bbrfkr/accelerator-keyboard/case/left/case_left-top_case_left.stl

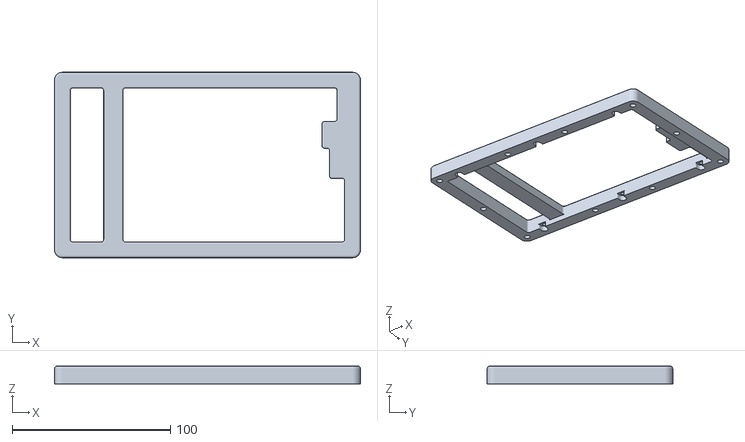
[picture p1: CAD file, 2024-07-12]
case/left/case_left-top_case_left.stl
193.5 x 117.3 x 11.2
