bbrfkr/accelerator-keyboard/case/right/case_right-bottom_right.stl

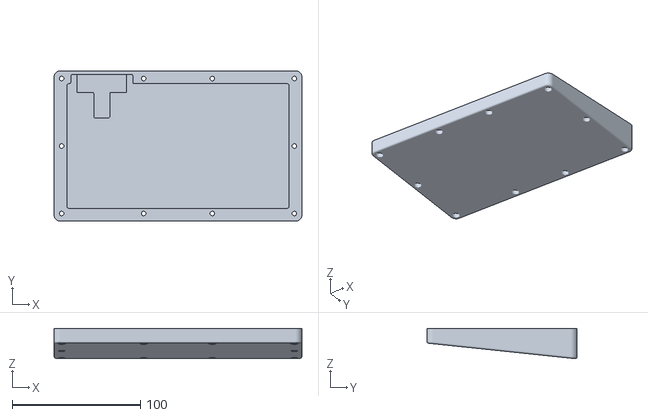
[picture p2: CAD file, 2024-07-12]
case/right/case_right-bottom_right.stl
193.5 x 117.3 x 23.7
