bbrfkr/accelerator-keyboard/pcb-left.dxf

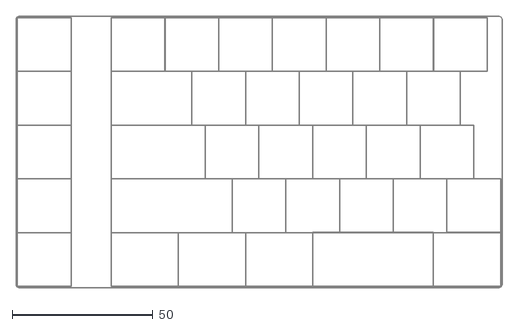
[picture p3: CAD file, 2024-07-12]
pcb-left.dxf
172.4 x 96.2
