bbrfkr/accelerator-keyboard/plate/org/plate-left.dxf

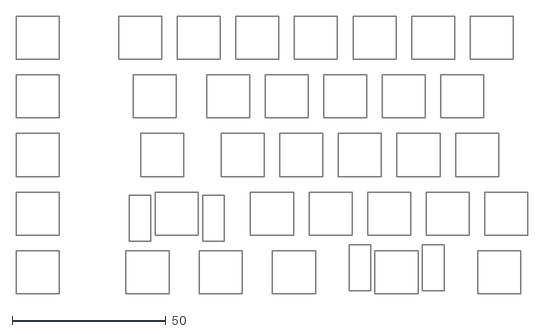
[picture p4: CAD file, 2024-05-05]
plate/org/plate-left.dxf
166.4 x 90.2
