bbrfkr/accelerator-keyboard/plate/plate.dxf

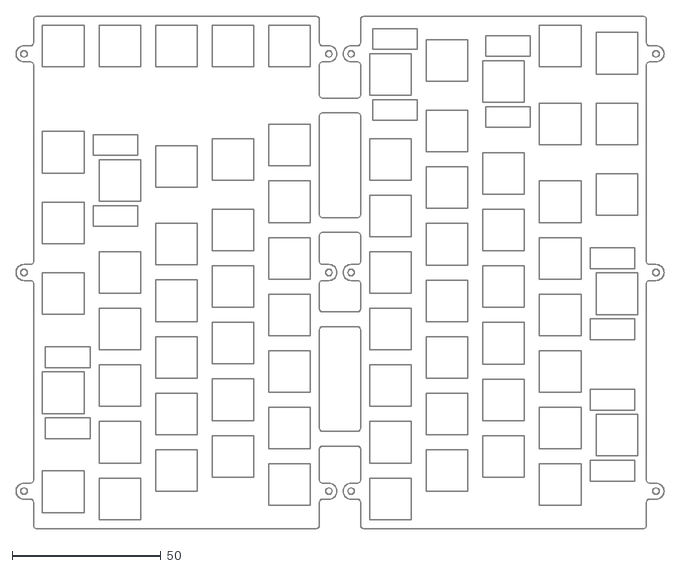
[picture p5: CAD file, 2024-07-12]
plate/plate.dxf
218.2 x 172.4
