bbrfkr/accelerator-keyboard/case/right/case_right.FCStd

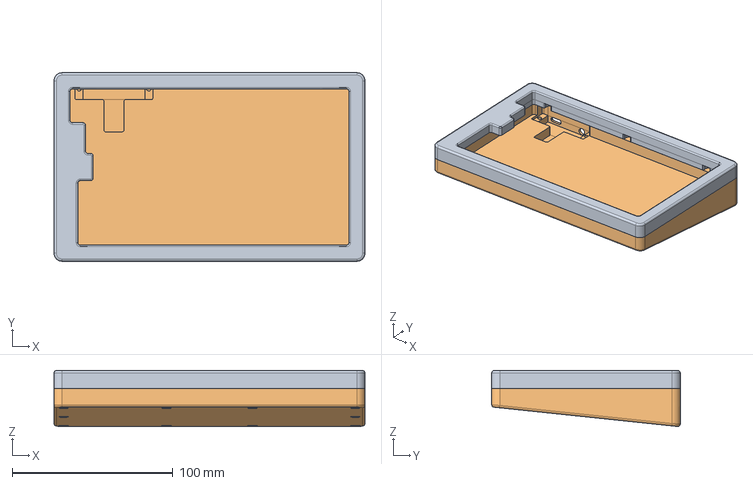
[picture p6: CAD file, 2024-07-12]
case/right/case_right.FCStd
193.5 x 117.3 x 34.9 mm
top_right
bottom_right
