bbrfkr/accelerator-keyboard/pcb-right.dxf

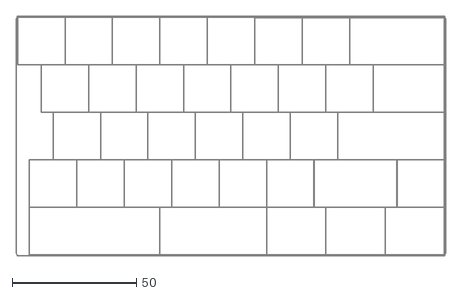
[picture p7: CAD file, 2024-07-12]
pcb-right.dxf
172.4 x 96.2
