bbrfkr/accelerator-keyboard/plate/org/plate-right.dxf

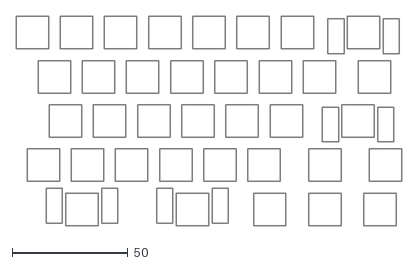
[picture p8: CAD file, 2024-05-05]
plate/org/plate-right.dxf
166.4 x 90.2
