bbrfkr/accelerator-keyboard/case/right/case_right-top_right.stl

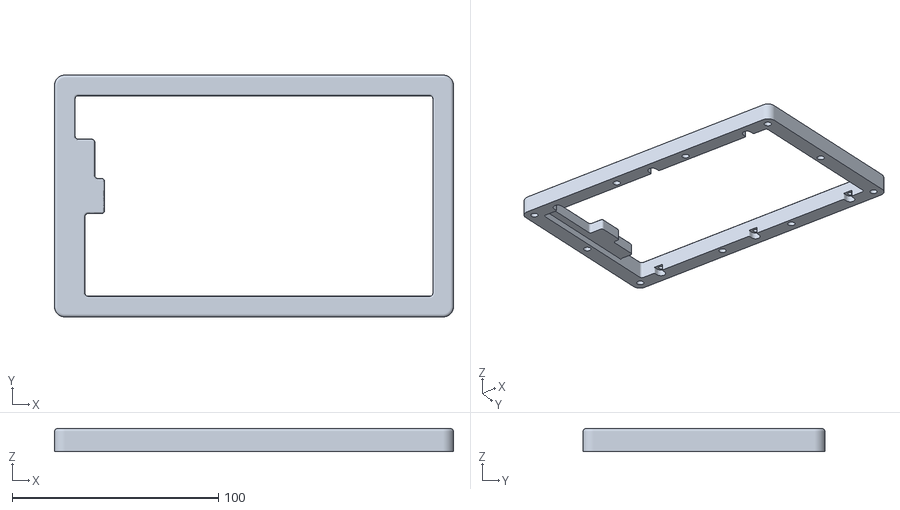
[picture p9: CAD file, 2024-07-12]
case/right/case_right-top_right.stl
193.5 x 117.3 x 11.2
