bbrfkr/accelerator-keyboard/(list of files, cad)

Other CAD files:
case/left/case_left-bottom_left.stl
