bbrfkr/accelerator-keyboard/accelerator.kicad_pcb

## KiCad design accelerator.kicad_pcb (2024-05-05)

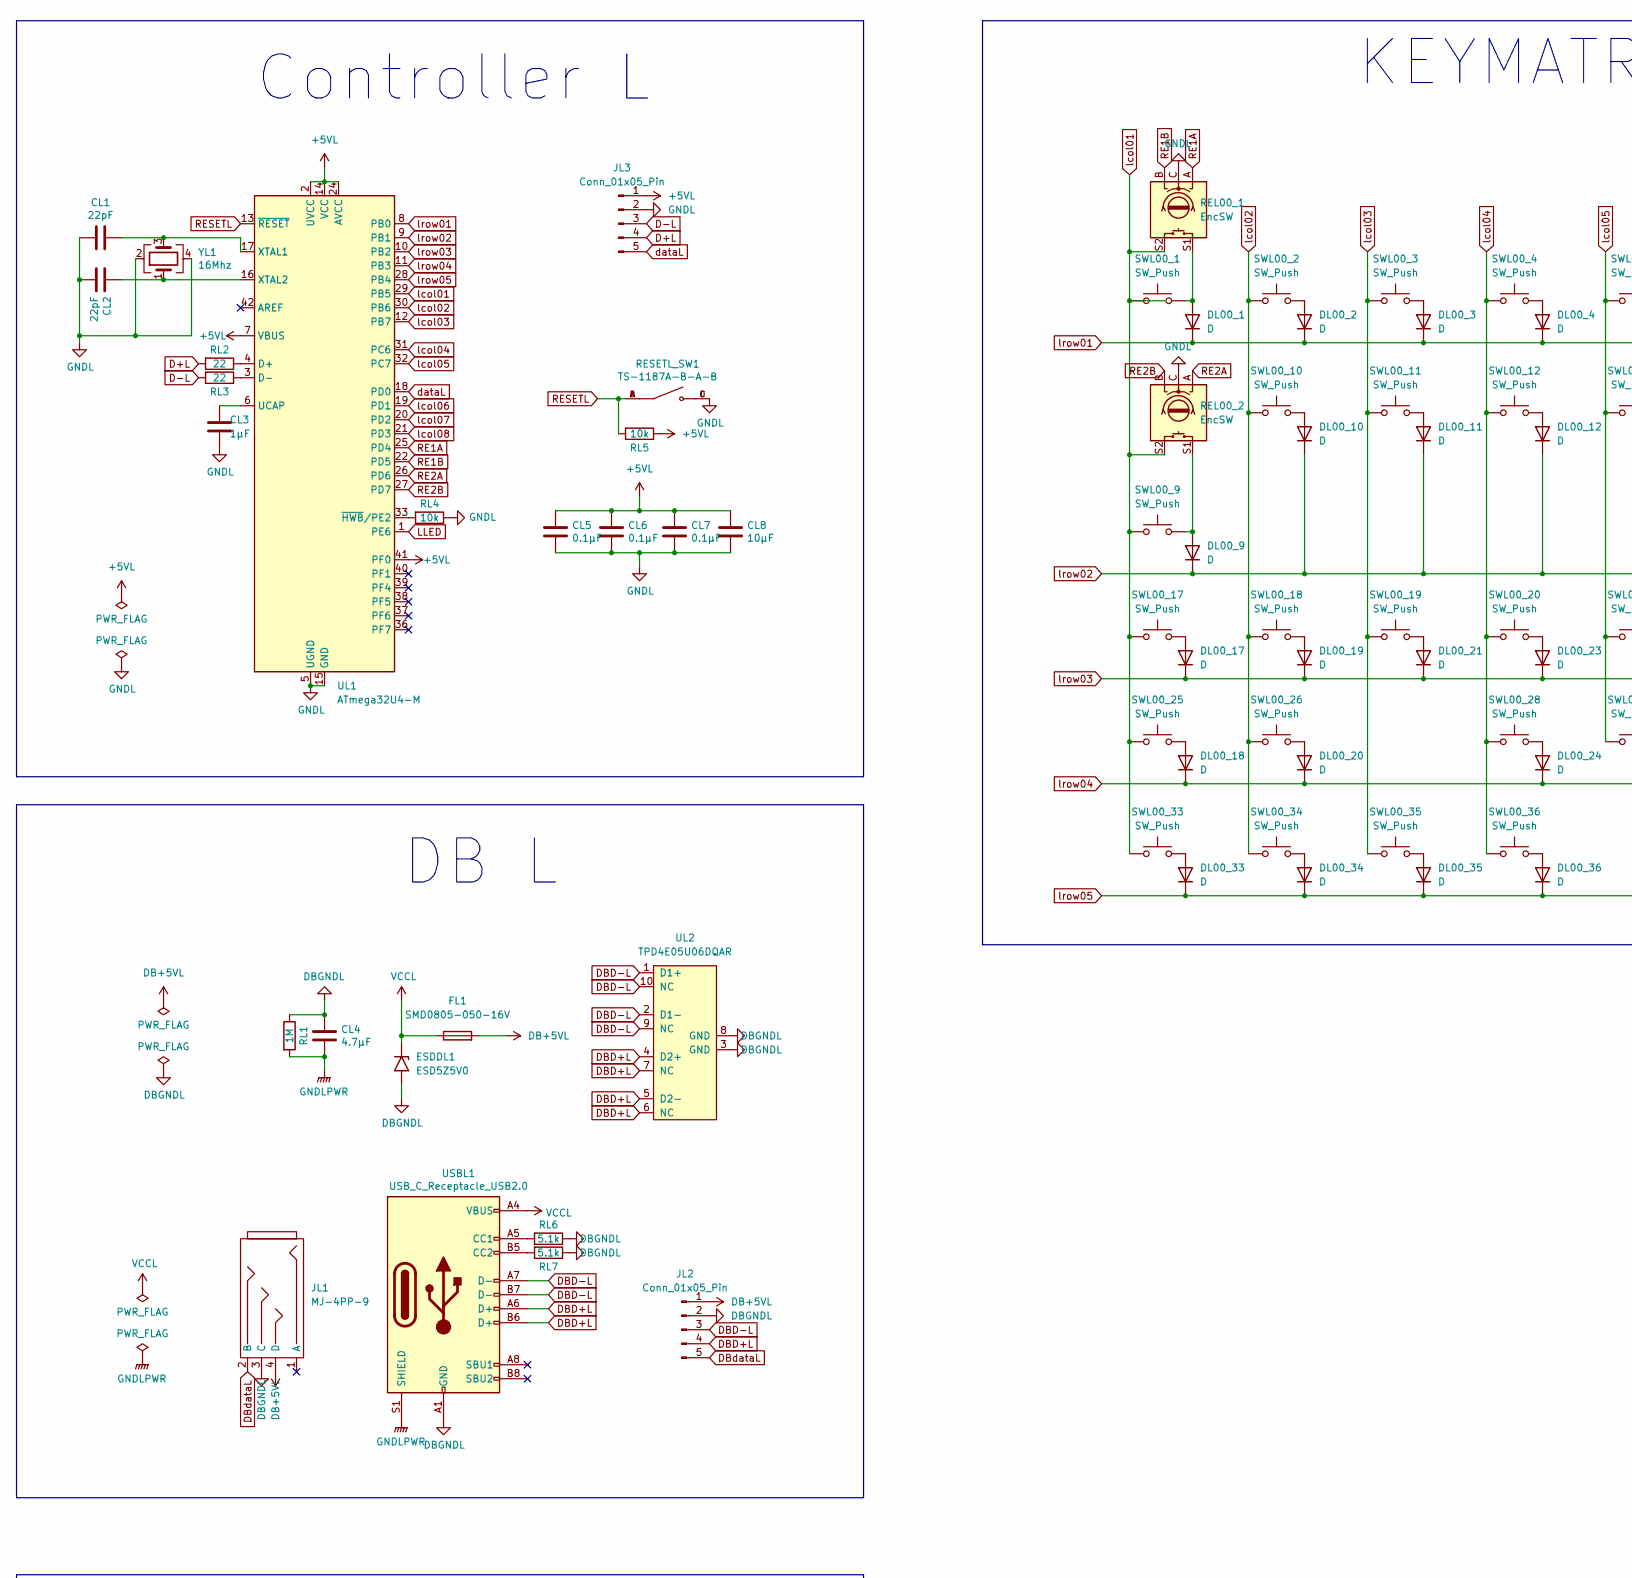
[picture p10: schematic accelerator.kicad_sch, part in row 1, column 1]

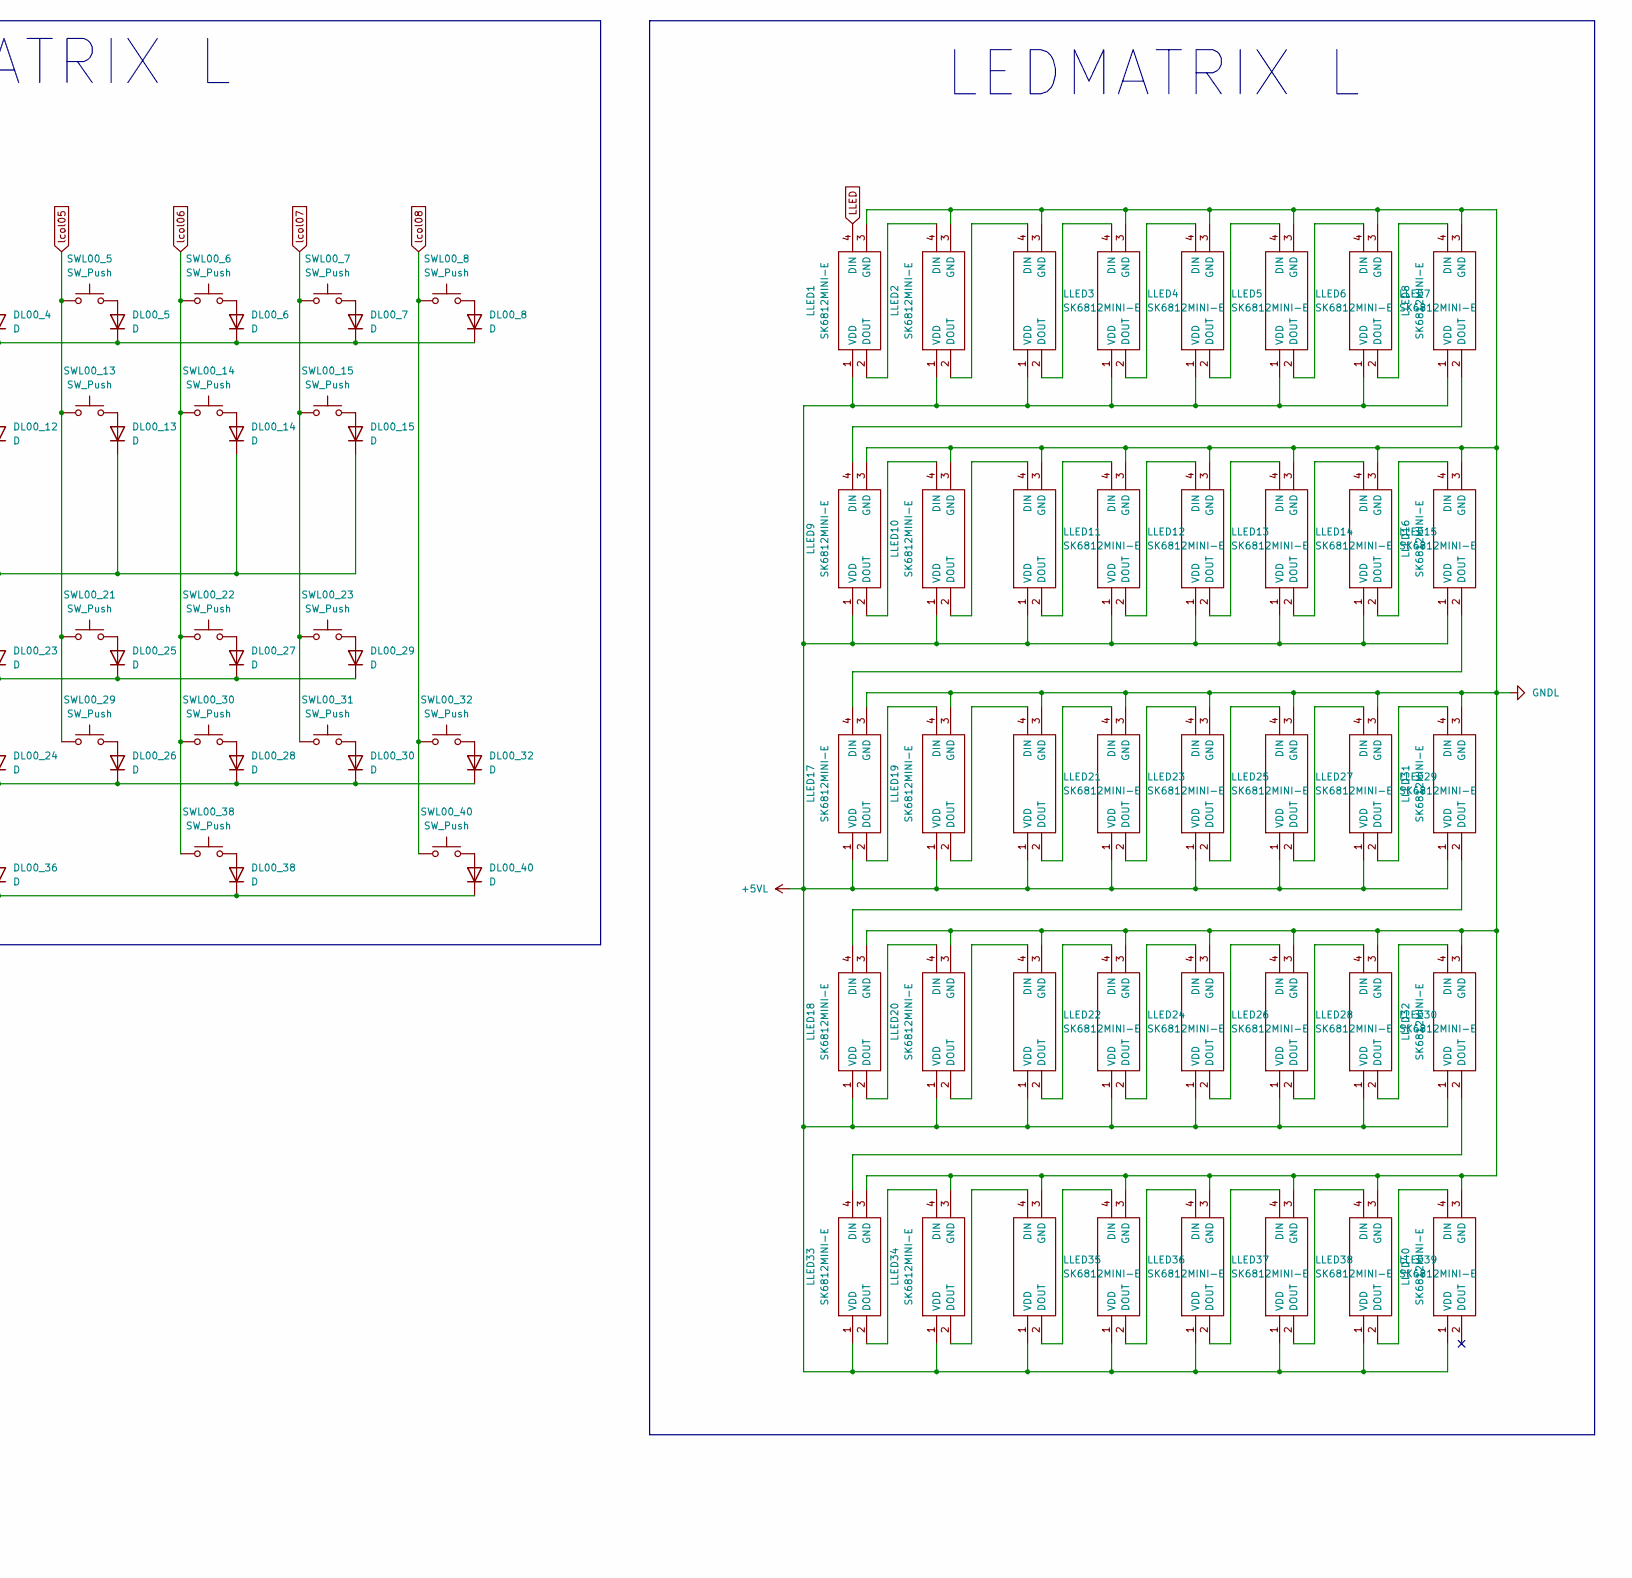
[picture p11: schematic accelerator.kicad_sch, part in row 1, column 2]

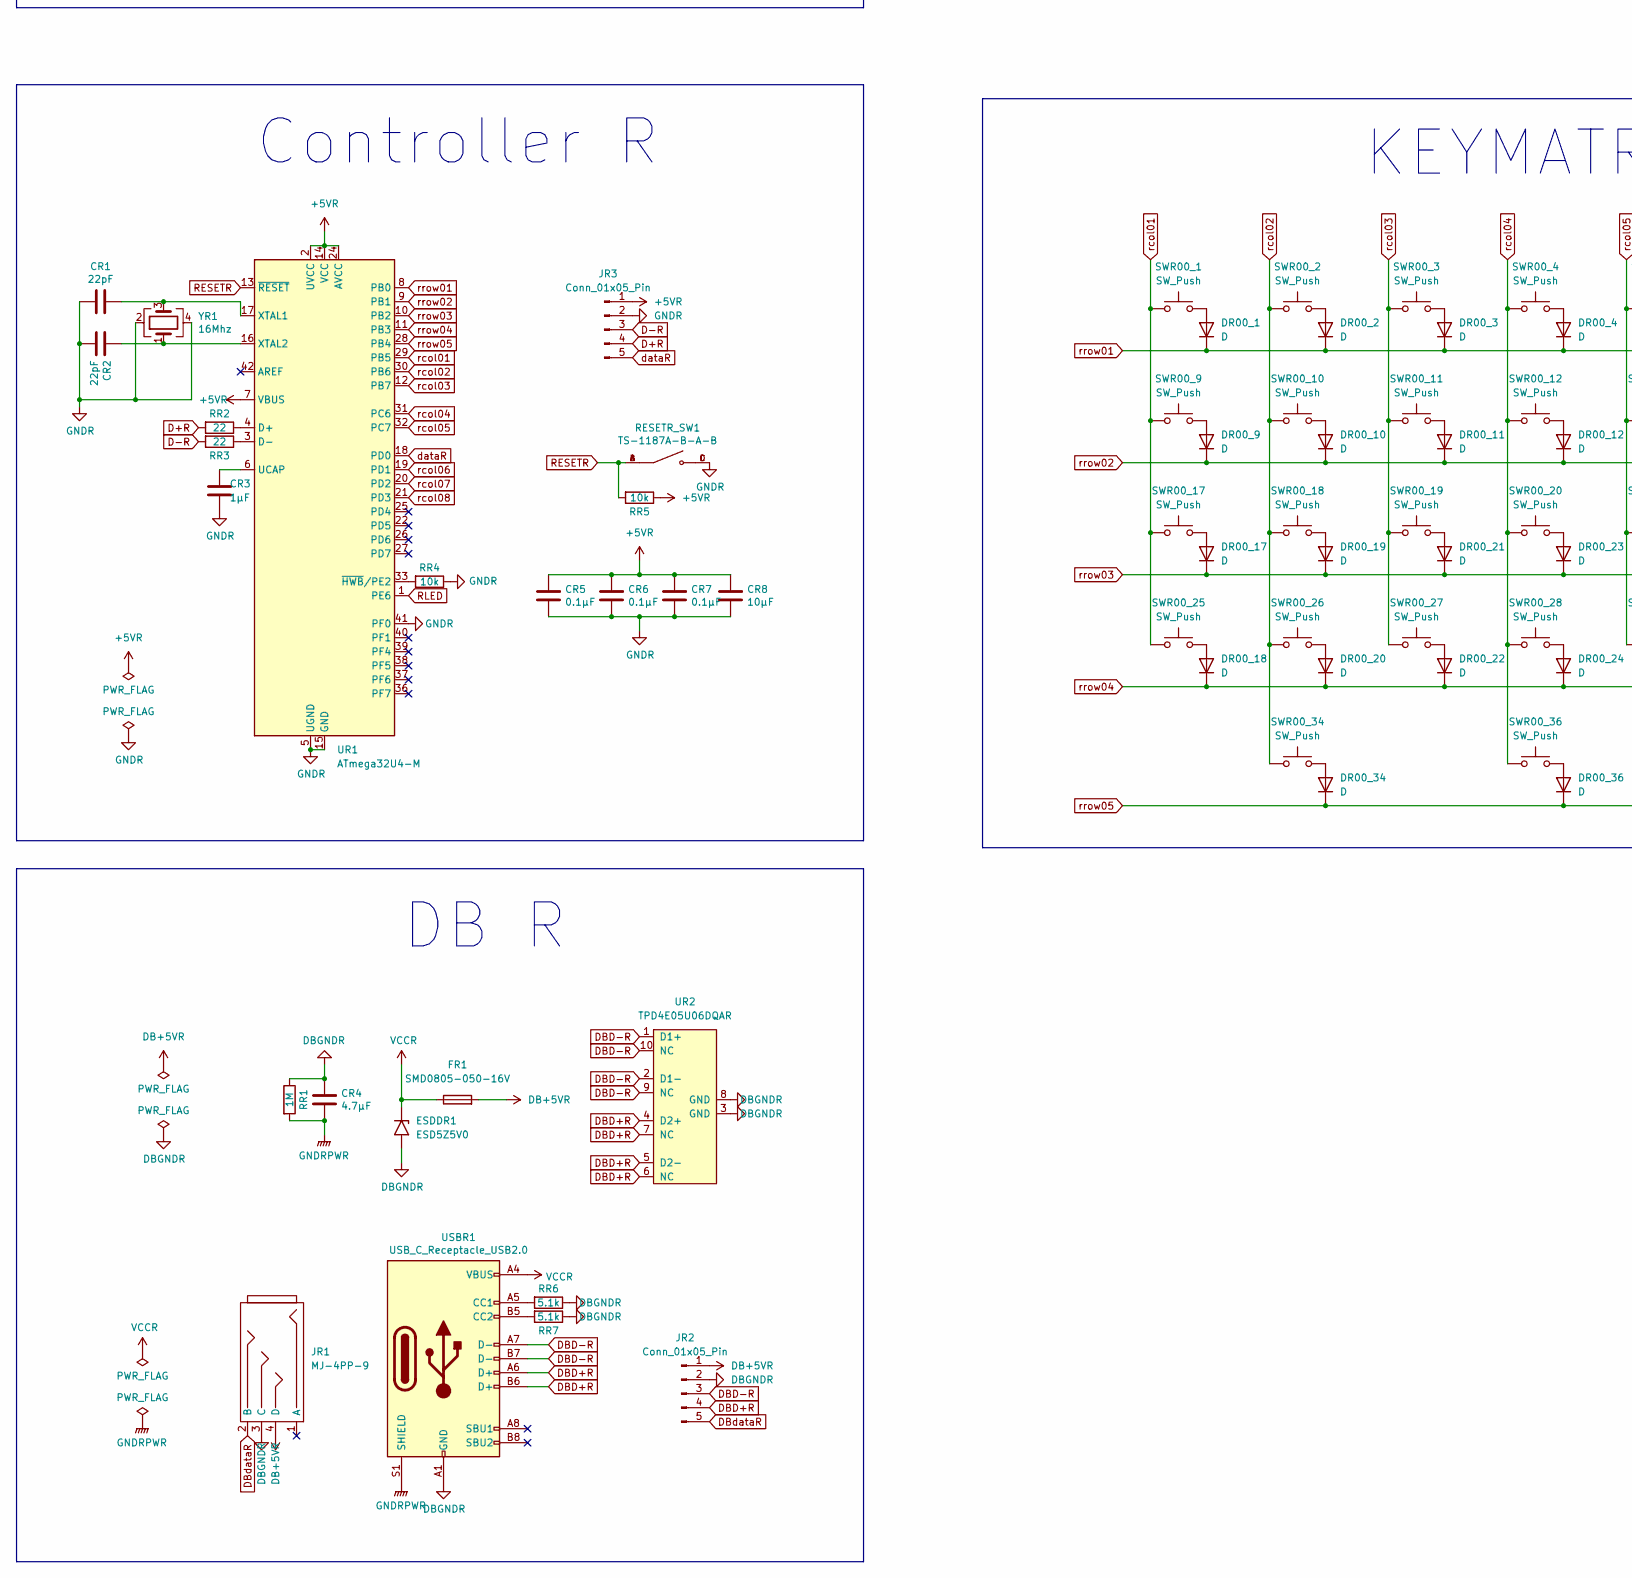
[picture p12: schematic accelerator.kicad_sch, part in row 2, column 1]

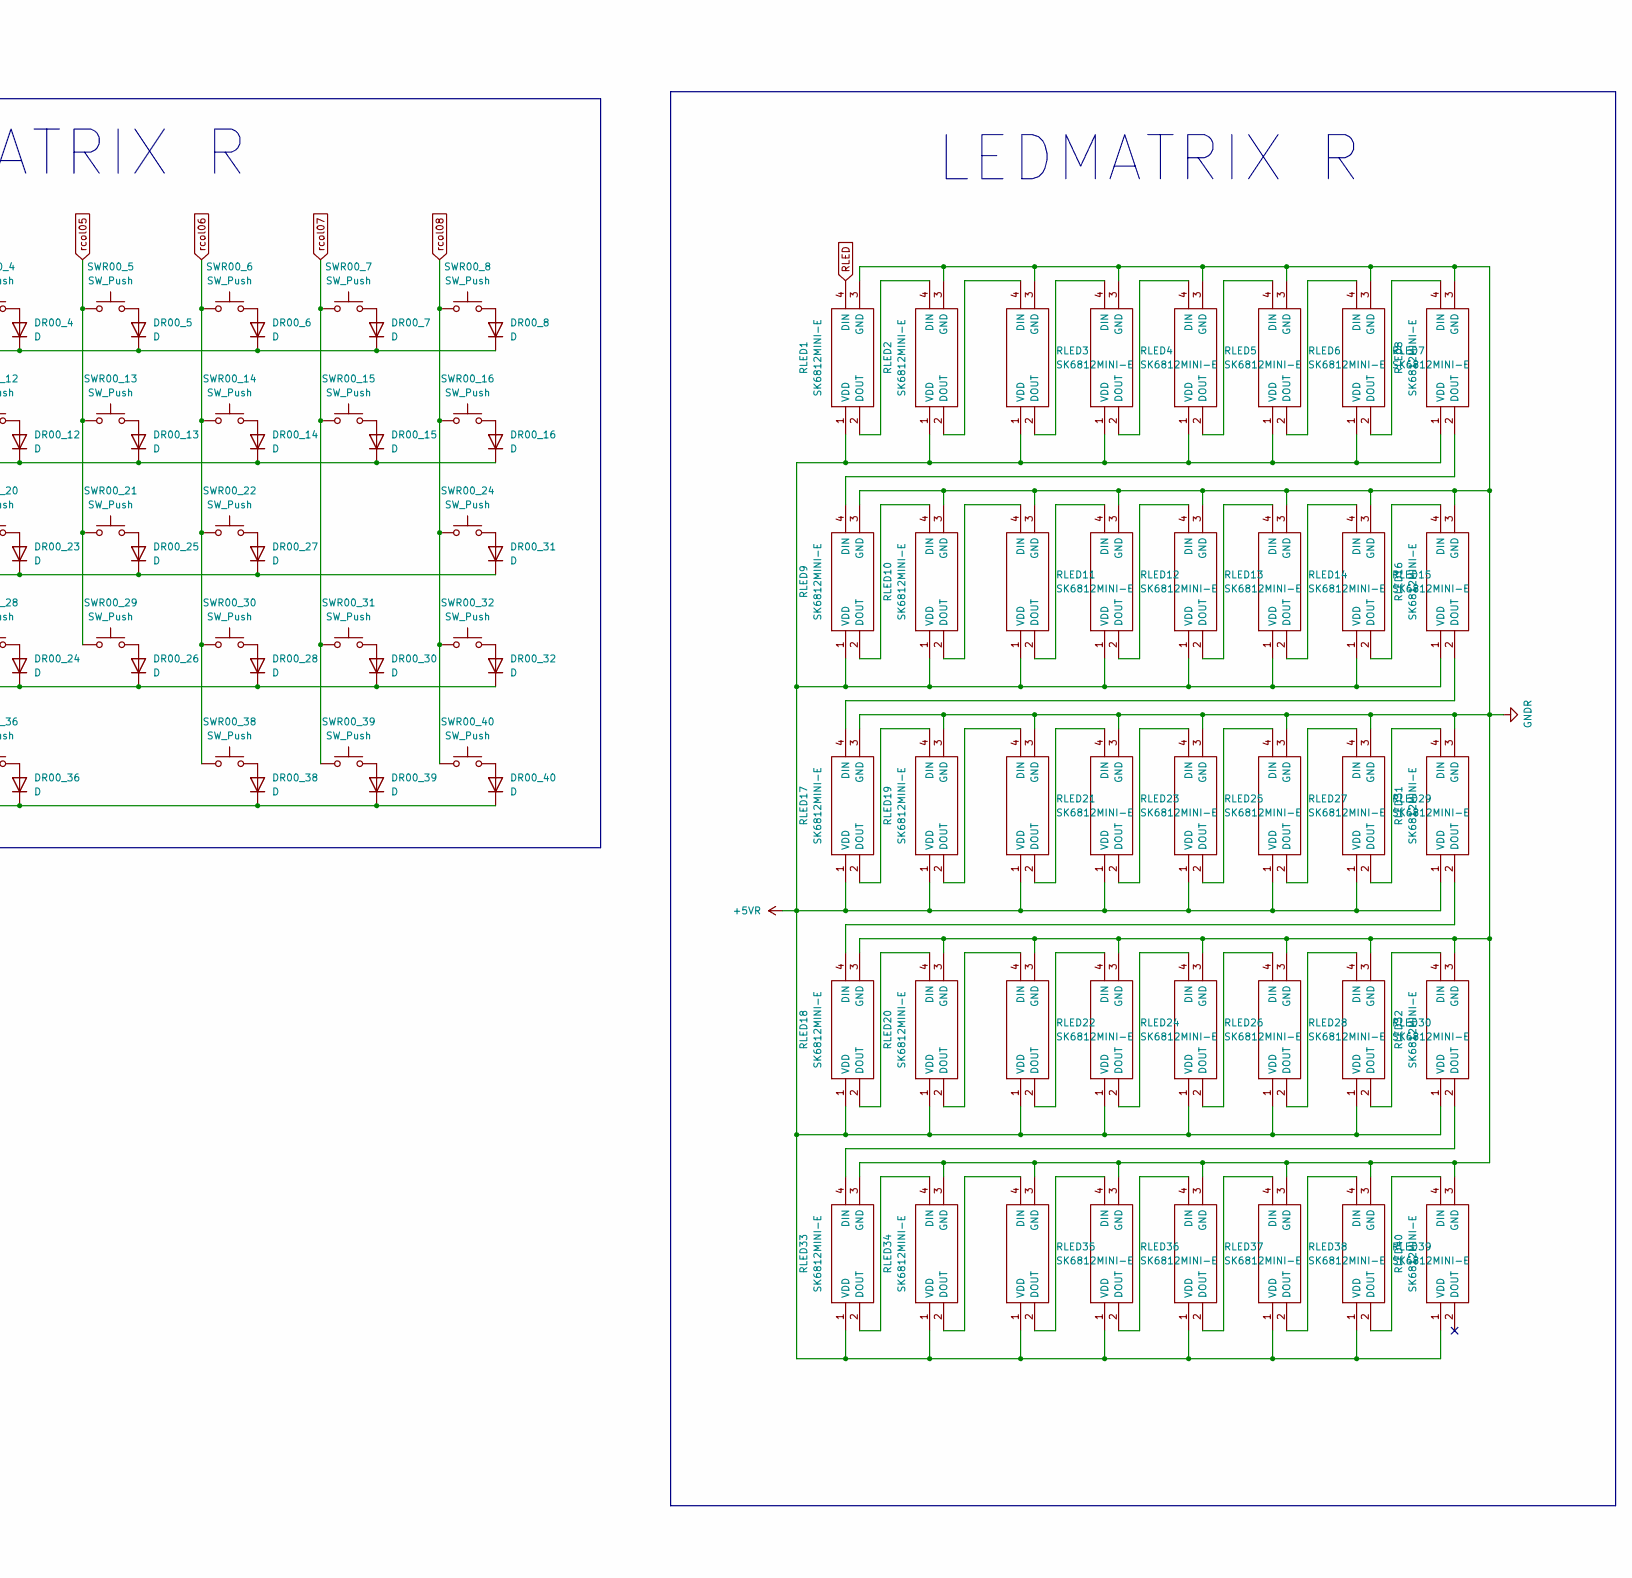
[picture p13: schematic accelerator.kicad_sch, part in row 2, column 2]

Parts:
CL1, CL2: 22pF; C_1206_3216Metric; LCSC C107174
CL3: 1μF; C_1206_3216Metric; LCSC C1848
CL4: 4.7μF; C_1206_3216Metric; LCSC C29823
CL5, CL6, CL7: 0.1μF; C_1206_3216Metric; LCSC C24497
CL8: 10μF; C_1206_3216Metric; LCSC C13585
CR1, CR2: 22pF; C_1206_3216Metric; LCSC C107174
CR3: 1μF; C_1206_3216Metric; LCSC C1848
CR4: 4.7μF; C_1206_3216Metric; LCSC C29823
CR5, CR6, CR7: 0.1μF; C_1206_3216Metric; LCSC C24497
CR8: 10μF; C_1206_3216Metric; LCSC C13585
DL00_1, DL00_2, DL00_3, DL00_4, DL00_5, DL00_6, DL00_7, DL00_8, DL00_9, DL00_10, DL00_11, DL00_12, DL00_13, DL00_14, DL00_15, DL00_17, DL00_18, DL00_19, DL00_20, DL00_21, DL00_23, DL00_24, DL00_25, DL00_26, DL00_27, DL00_28, DL00_29, DL00_30, DL00_32, DL00_33, DL00_34, DL00_35, DL00_36, DL00_38, DL00_40: D; D_SOD-123-Pretty; LCSC C81598
DR00_1, DR00_2, DR00_3, DR00_4, DR00_5, DR00_6, DR00_7, DR00_8, DR00_9, DR00_10, DR00_11, DR00_12, DR00_13, DR00_14, DR00_15, DR00_16, DR00_17, DR00_18, DR00_19, DR00_20, DR00_21, DR00_22, DR00_23, DR00_24, DR00_25, DR00_26, DR00_27, DR00_28, DR00_30, DR00_31, DR00_32, DR00_34, DR00_36, DR00_38, DR00_39, DR00_40: D; D_SOD-123-Pretty; LCSC C81598
ESDDL1: ESD5Z5V0; D_SOD-523; Manufacturer Part Number ESD5Z5V0; LCSC C502546
ESDDR1: ESD5Z5V0; D_SOD-523; Manufacturer Part Number ESD5Z5V0; LCSC C502546
FL1: SMD0805-050-16V; Fuse_1206_3216Metric; Manufacturer Part Number SMD0805-050-16V; LCSC C2833485
FR1: SMD0805-050-16V; Fuse_1206_3216Metric; Manufacturer Part Number SMD0805-050-16V; LCSC C2833485
JL1: MJ-4PP-9
JL2, JL3: Conn_01x05_Pin; JST_PH_S5B-PH-K_1x05_P2.00mm_Horizontal
JR1: MJ-4PP-9
JR2, JR3: Conn_01x05_Pin; JST_PH_S5B-PH-K_1x05_P2.00mm_Horizontal
LLED1, LLED2, LLED3, LLED4, LLED5, LLED6, LLED7, LLED8, LLED9, LLED10, LLED11, LLED12, LLED13, LLED14, LLED15, LLED16, LLED17, LLED18, LLED19, LLED20, LLED21, LLED22, LLED23, LLED24, LLED25, LLED26, LLED27, LLED28, LLED29, LLED30, LLED31, LLED32, LLED33, LLED34, LLED35, LLED36, LLED37, LLED38, LLED39, LLED40: SK6812MINI-E; SK6812MINIE; Manufacturer_Part_Number SK6812MINI-E; LCSC C5149201
REL00_1, REL00_2: EncSW; RotaryEncoder_Alps_EC12E-Switch_Vertical_H20mm
RESETL_SW1: TS-1187A-B-A-B; SW_TS-1187A-B-A-B; PARTREV A0; LCSC C318884
RESETR_SW1: TS-1187A-B-A-B; SW_TS-1187A-B-A-B; PARTREV A0; LCSC C318884
RL1: 1M; R_1206_3216Metric; LCSC C2759631
RL2, RL3: 22; R_1206_3216Metric; LCSC C17958
RL4, RL5: 10k; R_1206_3216Metric; LCSC C17928
RL6, RL7: 5.1k; R_1206_3216Metric; LCSC C964991
RLED1, RLED2, RLED3, RLED4, RLED5, RLED6, RLED7, RLED8, RLED9, RLED10, RLED11, RLED12, RLED13, RLED14, RLED15, RLED16, RLED17, RLED18, RLED19, RLED20, RLED21, RLED22, RLED23, RLED24, RLED25, RLED26, RLED27, RLED28, RLED29, RLED30, RLED31, RLED32, RLED33, RLED34, RLED35, RLED36, RLED37, RLED38, RLED39, RLED40: SK6812MINI-E; SK6812MINIE; Manufacturer_Part_Number SK6812MINI-E; LCSC C5149201
RR1: 1M; R_1206_3216Metric; LCSC C2759631
RR2, RR3: 22; R_1206_3216Metric; LCSC C17958
RR4, RR5: 10k; R_1206_3216Metric; LCSC C17928
RR6, RR7: 5.1k; R_1206_3216Metric; LCSC C964991
SWL00_1, SWL00_2, SWL00_3, SWL00_4, SWL00_5, SWL00_6, SWL00_7, SWL00_8, SWL00_9, SWL00_11, SWL00_12, SWL00_13, SWL00_14, SWL00_15, SWL00_17, SWL00_19, SWL00_20, SWL00_21, SWL00_22, SWL00_23, SWL00_25, SWL00_28, SWL00_29, SWL00_30, SWL00_31, SWL00_32, SWL00_33: SW_Push; MXOnly-1U-Hotswap; LCSC C5156480
SWL00_10: SW_Push; MXOnly-1.5U-Hotswap; LCSC C5156480
SWL00_18: SW_Push; MXOnly-1.75U-Hotswap; LCSC C5156480
SWL00_26: SW_Push; MXOnly-2.25U-Hotswap; LCSC C5156480
SWL00_34, SWL00_35, SWL00_36, SWL00_40: SW_Push; MXOnly-1.25U-Hotswap; LCSC C5156480
SWL00_38: SW_Push; MXOnly-2.25U-Hotswap-ReversedStabilizers; LCSC C5156480
SWR00_1, SWR00_2, SWR00_3, SWR00_4, SWR00_5, SWR00_6, SWR00_7, SWR00_9, SWR00_10, SWR00_11, SWR00_12, SWR00_13, SWR00_14, SWR00_15, SWR00_17, SWR00_18, SWR00_19, SWR00_20, SWR00_21, SWR00_22, SWR00_25, SWR00_26, SWR00_27, SWR00_28, SWR00_29, SWR00_30, SWR00_32: SW_Push; MXOnly-1U-Hotswap; LCSC C5156480
SWR00_8: SW_Push; MXOnly-2U-Hotswap; LCSC C5156480
SWR00_16: SW_Push; MXOnly-1.5U-Hotswap; LCSC C5156480
SWR00_24: SW_Push; MXOnly-2.25U-Hotswap; LCSC C5156480
SWR00_31: SW_Push; MXOnly-1.75U-Hotswap; LCSC C5156480
SWR00_34: SW_Push; MXOnly-2.75U-Hotswap-ReversedStabilizers; LCSC C5156480
SWR00_36: SW_Push; MXOnly-2.25U-Hotswap-ReversedStabilizers; LCSC C5156480
SWR00_38, SWR00_39, SWR00_40: SW_Push; MXOnly-1.25U-Hotswap; LCSC C5156480
UL1: ATmega32U4-M; QFN-44-1EP_7x7mm_P0.5mm_EP5.2x5.2mm; LCSC C112161
UL2: TPD4E05U06DQAR; USON-10_L2.5-W1.0-P0.50-BL; LCSC C2836386
UR1: ATmega32U4-M; QFN-44-1EP_7x7mm_P0.5mm_EP5.2x5.2mm; LCSC C112161
UR2: TPD4E05U06DQAR; USON-10_L2.5-W1.0-P0.50-BL; LCSC C2836386
USBL1: USB_C_Receptacle_USB2.0; USB_C_Receptacle_HRO_TYPE-C-31-M-12; LCSC C165948
USBR1: USB_C_Receptacle_USB2.0; USB_C_Receptacle_HRO_TYPE-C-31-M-12; LCSC C165948
YL1: 16Mhz; OSC-SMD_4P-L3.2-W2.5-BL; LCSC C13738
YR1: 16Mhz; OSC-SMD_4P-L3.2-W2.5-BL; LCSC C13738

Connections:
+5VL: CL5.1, CL6.1, CL7.1, CL8.1, JL3.1, LLED1.1 (VDD), LLED2.1 (VDD), LLED3.1 (VDD), LLED4.1 (VDD), LLED5.1 (VDD), LLED6.1 (VDD), LLED7.1 (VDD), LLED8.1 (VDD), LLED9.1 (VDD), LLED10.1 (VDD), LLED11.1 (VDD), LLED12.1 (VDD), LLED13.1 (VDD), LLED14.1 (VDD), LLED15.1 (VDD), LLED16.1 (VDD), LLED17.1 (VDD), LLED18.1 (VDD), LLED19.1 (VDD), LLED20.1 (VDD), LLED21.1 (VDD), LLED22.1 (VDD), LLED23.1 (VDD), LLED24.1 (VDD), LLED25.1 (VDD), LLED26.1 (VDD), LLED27.1 (VDD), LLED28.1 (VDD), LLED29.1 (VDD), LLED30.1 (VDD), LLED31.1 (VDD), LLED32.1 (VDD), LLED33.1 (VDD), LLED34.1 (VDD), LLED35.1 (VDD), LLED36.1 (VDD), LLED37.1 (VDD), LLED38.1 (VDD), LLED39.1 (VDD), LLED40.1 (VDD), RL5.1, UL1.2 (UVCC), UL1.7 (VBUS), UL1.14 (VCC), UL1.24 (AVCC), UL1.34 (VCC), UL1.41 (PF0), UL1.44 (AVCC)
+5VR: CR5.1, CR6.1, CR7.1, CR8.1, JR3.1, RLED1.1 (VDD), RLED2.1 (VDD), RLED3.1 (VDD), RLED4.1 (VDD), RLED5.1 (VDD), RLED6.1 (VDD), RLED7.1 (VDD), RLED8.1 (VDD), RLED9.1 (VDD), RLED10.1 (VDD), RLED11.1 (VDD), RLED12.1 (VDD), RLED13.1 (VDD), RLED14.1 (VDD), RLED15.1 (VDD), RLED16.1 (VDD), RLED17.1 (VDD), RLED18.1 (VDD), RLED19.1 (VDD), RLED20.1 (VDD), RLED21.1 (VDD), RLED22.1 (VDD), RLED23.1 (VDD), RLED24.1 (VDD), RLED25.1 (VDD), RLED26.1 (VDD), RLED27.1 (VDD), RLED28.1 (VDD), RLED29.1 (VDD), RLED30.1 (VDD), RLED31.1 (VDD), RLED32.1 (VDD), RLED33.1 (VDD), RLED34.1 (VDD), RLED35.1 (VDD), RLED36.1 (VDD), RLED37.1 (VDD), RLED38.1 (VDD), RLED39.1 (VDD), RLED40.1 (VDD), RR5.1, UR1.2 (UVCC), UR1.7 (VBUS), UR1.14 (VCC), UR1.24 (AVCC), UR1.34 (VCC), UR1.44 (AVCC)
D+L: JL3.4, RL2.2
D+R: JR3.4, RR2.2
D-L: JL3.3, RL3.2
D-R: JR3.3, RR3.2
DB+5VL: FL1.2, JL1.4 (D), JL2.1
DB+5VR: FR1.2, JR1.4 (D), JR2.1
DBD+L: JL2.4, UL2.4 (D2+), UL2.5 (D2-), UL2.6 (NC), UL2.7 (NC), USBL1.A6 (D+), USBL1.B6 (D+)
DBD+R: JR2.4, UR2.4 (D2+), UR2.5 (D2-), UR2.6 (NC), UR2.7 (NC), USBR1.A6 (D+), USBR1.B6 (D+)
DBD-L: JL2.3, UL2.1 (D1+), UL2.2 (D1-), UL2.9 (NC), UL2.10 (NC), USBL1.A7 (D-), USBL1.B7 (D-)
DBD-R: JR2.3, UR2.1 (D1+), UR2.2 (D1-), UR2.9 (NC), UR2.10 (NC), USBR1.A7 (D-), USBR1.B7 (D-)
DBGNDL: CL4.1, ESDDL1.2 (A2), JL1.3 (C), JL2.2, RL1.1, RL6.1, RL7.1, UL2.3 (GND), UL2.8 (GND), USBL1.A1 (GND), USBL1.A12 (GND), USBL1.B1 (GND), USBL1.B12 (GND)
DBGNDR: CR4.1, ESDDR1.2 (A2), JR1.3 (C), JR2.2, RR1.1, RR6.1, RR7.1, UR2.3 (GND), UR2.8 (GND), USBR1.A1 (GND), USBR1.A12 (GND), USBR1.B1 (GND), USBR1.B12 (GND)
DBdataL: JL1.2 (B), JL2.5
DBdataR: JR1.2 (B), JR2.5
GNDL: CL1.1, CL2.2, CL3.2, CL5.2, CL6.2, CL7.2, CL8.2, JL3.2, LLED1.3 (GND), LLED2.3 (GND), LLED3.3 (GND), LLED4.3 (GND), LLED5.3 (GND), LLED6.3 (GND), LLED7.3 (GND), LLED8.3 (GND), LLED9.3 (GND), LLED10.3 (GND), LLED11.3 (GND), LLED12.3 (GND), LLED13.3 (GND), LLED14.3 (GND), LLED15.3 (GND), LLED16.3 (GND), LLED17.3 (GND), LLED18.3 (GND), LLED19.3 (GND), LLED20.3 (GND), LLED21.3 (GND), LLED22.3 (GND), LLED23.3 (GND), LLED24.3 (GND), LLED25.3 (GND), LLED26.3 (GND), LLED27.3 (GND), LLED28.3 (GND), LLED29.3 (GND), LLED30.3 (GND), LLED31.3 (GND), LLED32.3 (GND), LLED33.3 (GND), LLED34.3 (GND), LLED35.3 (GND), LLED36.3 (GND), LLED37.3 (GND), LLED38.3 (GND), LLED39.3 (GND), LLED40.3 (GND), REL00_1.C, REL00_2.C, RESETL_SW1.C, RESETL_SW1.D, RL4.1, UL1.5 (UGND), UL1.15 (GND), UL1.23 (GND), UL1.35 (GND), UL1.43 (GND), UL1.45 (GND), YL1.2, YL1.4
GNDLPWR: CL4.2, RL1.2, USBL1.S1 (SHIELD)
GNDR: CR1.1, CR2.2, CR3.2, CR5.2, CR6.2, CR7.2, CR8.2, JR3.2, RESETR_SW1.C, RESETR_SW1.D, RLED1.3 (GND), RLED2.3 (GND), RLED3.3 (GND), RLED4.3 (GND), RLED5.3 (GND), RLED6.3 (GND), RLED7.3 (GND), RLED8.3 (GND), RLED9.3 (GND), RLED10.3 (GND), RLED11.3 (GND), RLED12.3 (GND), RLED13.3 (GND), RLED14.3 (GND), RLED15.3 (GND), RLED16.3 (GND), RLED17.3 (GND), RLED18.3 (GND), RLED19.3 (GND), RLED20.3 (GND), RLED21.3 (GND), RLED22.3 (GND), RLED23.3 (GND), RLED24.3 (GND), RLED25.3 (GND), RLED26.3 (GND), RLED27.3 (GND), RLED28.3 (GND), RLED29.3 (GND), RLED30.3 (GND), RLED31.3 (GND), RLED32.3 (GND), RLED33.3 (GND), RLED34.3 (GND), RLED35.3 (GND), RLED36.3 (GND), RLED37.3 (GND), RLED38.3 (GND), RLED39.3 (GND), RLED40.3 (GND), RR4.1, UR1.5 (UGND), UR1.15 (GND), UR1.23 (GND), UR1.35 (GND), UR1.41 (PF0), UR1.43 (GND), UR1.45 (GND), YR1.2, YR1.4
GNDRPWR: CR4.2, RR1.2, USBR1.S1 (SHIELD)
LLED: LLED1.4 (DIN), UL1.1 (PE6)
unnamed: DL00_1.2 (A), REL00_1.S1, SWL00_1.2
unnamed: DL00_2.2 (A), SWL00_2.2
unnamed: DL00_3.2 (A), SWL00_3.2
unnamed: DL00_4.2 (A), SWL00_4.2
unnamed: DL00_5.2 (A), SWL00_5.2
unnamed: DL00_6.2 (A), SWL00_6.2
unnamed: DL00_7.2 (A), SWL00_7.2
unnamed: DL00_8.2 (A), SWL00_8.2
unnamed: DL00_9.2 (A), REL00_2.S1, SWL00_9.2
unnamed: DL00_10.2 (A), SWL00_10.2
unnamed: DL00_11.2 (A), SWL00_11.2
unnamed: DL00_12.2 (A), SWL00_12.2
unnamed: DL00_13.2 (A), SWL00_13.2
unnamed: DL00_14.2 (A), SWL00_14.2
unnamed: DL00_15.2 (A), SWL00_15.2
unnamed: DL00_17.2 (A), SWL00_17.2
unnamed: DL00_18.2 (A), SWL00_25.2
unnamed: DL00_19.2 (A), SWL00_18.2
unnamed: DL00_20.2 (A), SWL00_26.2
unnamed: DL00_21.2 (A), SWL00_19.2
unnamed: DL00_23.2 (A), SWL00_20.2
unnamed: DL00_24.2 (A), SWL00_28.2
unnamed: DL00_25.2 (A), SWL00_21.2
unnamed: DL00_26.2 (A), SWL00_29.2
unnamed: DL00_27.2 (A), SWL00_22.2
unnamed: DL00_28.2 (A), SWL00_30.2
unnamed: DL00_29.2 (A), SWL00_23.2
unnamed: DL00_30.2 (A), SWL00_31.2
unnamed: DL00_32.2 (A), SWL00_32.2
unnamed: DL00_33.2 (A), SWL00_33.2
unnamed: DL00_34.2 (A), SWL00_34.2
unnamed: DL00_35.2 (A), SWL00_35.2
unnamed: DL00_36.2 (A), SWL00_36.2
unnamed: DL00_38.2 (A), SWL00_38.2
unnamed: DL00_40.2 (A), SWL00_40.2
unnamed: DR00_1.2 (A), SWR00_1.2
unnamed: DR00_2.2 (A), SWR00_2.2
unnamed: DR00_3.2 (A), SWR00_3.2
unnamed: DR00_4.2 (A), SWR00_4.2
unnamed: DR00_5.2 (A), SWR00_5.2
unnamed: DR00_6.2 (A), SWR00_6.2
unnamed: DR00_7.2 (A), SWR00_7.2
unnamed: DR00_8.2 (A), SWR00_8.2
unnamed: DR00_9.2 (A), SWR00_9.2
unnamed: DR00_10.2 (A), SWR00_10.2
unnamed: DR00_11.2 (A), SWR00_11.2
unnamed: DR00_12.2 (A), SWR00_12.2
unnamed: DR00_13.2 (A), SWR00_13.2
unnamed: DR00_14.2 (A), SWR00_14.2
unnamed: DR00_15.2 (A), SWR00_15.2
unnamed: DR00_16.2 (A), SWR00_16.2
unnamed: DR00_17.2 (A), SWR00_17.2
unnamed: DR00_18.2 (A), SWR00_25.2
unnamed: DR00_19.2 (A), SWR00_18.2
unnamed: DR00_20.2 (A), SWR00_26.2
unnamed: DR00_21.2 (A), SWR00_19.2
unnamed: DR00_22.2 (A), SWR00_27.2
unnamed: DR00_23.2 (A), SWR00_20.2
unnamed: DR00_24.2 (A), SWR00_28.2
unnamed: DR00_25.2 (A), SWR00_21.2
unnamed: DR00_26.2 (A), SWR00_29.2
unnamed: DR00_27.2 (A), SWR00_22.2
unnamed: DR00_28.2 (A), SWR00_30.2
unnamed: DR00_30.2 (A), SWR00_31.2
unnamed: DR00_31.2 (A), SWR00_24.2
unnamed: DR00_32.2 (A), SWR00_32.2
unnamed: DR00_34.2 (A), SWR00_34.2
unnamed: DR00_36.2 (A), SWR00_36.2
unnamed: DR00_38.2 (A), SWR00_38.2
unnamed: DR00_39.2 (A), SWR00_39.2
unnamed: DR00_40.2 (A), SWR00_40.2
unnamed: LLED1.2 (DOUT), LLED2.4 (DIN)
unnamed: LLED2.2 (DOUT), LLED3.4 (DIN)
unnamed: LLED3.2 (DOUT), LLED4.4 (DIN)
unnamed: LLED4.2 (DOUT), LLED5.4 (DIN)
unnamed: LLED5.2 (DOUT), LLED6.4 (DIN)
unnamed: LLED6.2 (DOUT), LLED7.4 (DIN)
unnamed: LLED7.2 (DOUT), LLED8.4 (DIN)
unnamed: LLED8.2 (DOUT), LLED9.4 (DIN)
unnamed: LLED9.2 (DOUT), LLED10.4 (DIN)
unnamed: LLED10.2 (DOUT), LLED11.4 (DIN)
unnamed: LLED11.2 (DOUT), LLED12.4 (DIN)
unnamed: LLED12.2 (DOUT), LLED13.4 (DIN)
unnamed: LLED13.2 (DOUT), LLED14.4 (DIN)
unnamed: LLED14.2 (DOUT), LLED15.4 (DIN)
unnamed: LLED15.2 (DOUT), LLED16.4 (DIN)
unnamed: LLED16.2 (DOUT), LLED17.4 (DIN)
unnamed: LLED17.2 (DOUT), LLED19.4 (DIN)
unnamed: LLED18.4 (DIN), LLED31.2 (DOUT)
unnamed: LLED18.2 (DOUT), LLED20.4 (DIN)
unnamed: LLED19.2 (DOUT), LLED21.4 (DIN)
unnamed: LLED20.2 (DOUT), LLED22.4 (DIN)
unnamed: LLED21.2 (DOUT), LLED23.4 (DIN)
unnamed: LLED22.2 (DOUT), LLED24.4 (DIN)
unnamed: LLED23.2 (DOUT), LLED25.4 (DIN)
unnamed: LLED24.2 (DOUT), LLED26.4 (DIN)
unnamed: LLED25.2 (DOUT), LLED27.4 (DIN)
unnamed: LLED26.2 (DOUT), LLED28.4 (DIN)
unnamed: LLED27.2 (DOUT), LLED29.4 (DIN)
unnamed: LLED28.2 (DOUT), LLED30.4 (DIN)
unnamed: LLED29.2 (DOUT), LLED31.4 (DIN)
unnamed: LLED30.2 (DOUT), LLED32.4 (DIN)
unnamed: LLED32.2 (DOUT), LLED33.4 (DIN)
unnamed: LLED33.2 (DOUT), LLED34.4 (DIN)
unnamed: LLED34.2 (DOUT), LLED35.4 (DIN)
unnamed: LLED35.2 (DOUT), LLED36.4 (DIN)
unnamed: LLED36.2 (DOUT), LLED37.4 (DIN)
unnamed: LLED37.2 (DOUT), LLED38.4 (DIN)
unnamed: LLED38.2 (DOUT), LLED39.4 (DIN)
unnamed: LLED39.2 (DOUT), LLED40.4 (DIN)
unnamed: RLED1.2 (DOUT), RLED2.4 (DIN)
unnamed: RLED2.2 (DOUT), RLED3.4 (DIN)
unnamed: RLED3.2 (DOUT), RLED4.4 (DIN)
unnamed: RLED4.2 (DOUT), RLED5.4 (DIN)
unnamed: RLED5.2 (DOUT), RLED6.4 (DIN)
unnamed: RLED6.2 (DOUT), RLED7.4 (DIN)
unnamed: RLED7.2 (DOUT), RLED8.4 (DIN)
unnamed: RLED8.2 (DOUT), RLED9.4 (DIN)
unnamed: RLED9.2 (DOUT), RLED10.4 (DIN)
unnamed: RLED10.2 (DOUT), RLED11.4 (DIN)
unnamed: RLED11.2 (DOUT), RLED12.4 (DIN)
unnamed: RLED12.2 (DOUT), RLED13.4 (DIN)
unnamed: RLED13.2 (DOUT), RLED14.4 (DIN)
unnamed: RLED14.2 (DOUT), RLED15.4 (DIN)
unnamed: RLED15.2 (DOUT), RLED16.4 (DIN)
unnamed: RLED16.2 (DOUT), RLED17.4 (DIN)
unnamed: RLED17.2 (DOUT), RLED19.4 (DIN)
unnamed: RLED18.4 (DIN), RLED31.2 (DOUT)
unnamed: RLED18.2 (DOUT), RLED20.4 (DIN)
unnamed: RLED19.2 (DOUT), RLED21.4 (DIN)
unnamed: RLED20.2 (DOUT), RLED22.4 (DIN)
unnamed: RLED21.2 (DOUT), RLED23.4 (DIN)
unnamed: RLED22.2 (DOUT), RLED24.4 (DIN)
unnamed: RLED23.2 (DOUT), RLED25.4 (DIN)
unnamed: RLED24.2 (DOUT), RLED26.4 (DIN)
unnamed: RLED25.2 (DOUT), RLED27.4 (DIN)
unnamed: RLED26.2 (DOUT), RLED28.4 (DIN)
unnamed: RLED27.2 (DOUT), RLED29.4 (DIN)
unnamed: RLED28.2 (DOUT), RLED30.4 (DIN)
unnamed: RLED29.2 (DOUT), RLED31.4 (DIN)
unnamed: RLED30.2 (DOUT), RLED32.4 (DIN)
unnamed: RLED32.2 (DOUT), RLED33.4 (DIN)
unnamed: RLED33.2 (DOUT), RLED34.4 (DIN)
unnamed: RLED34.2 (DOUT), RLED35.4 (DIN)
unnamed: RLED35.2 (DOUT), RLED36.4 (DIN)
unnamed: RLED36.2 (DOUT), RLED37.4 (DIN)
unnamed: RLED37.2 (DOUT), RLED38.4 (DIN)
unnamed: RLED38.2 (DOUT), RLED39.4 (DIN)
unnamed: RLED39.2 (DOUT), RLED40.4 (DIN)
unnamed: RL2.1, UL1.4 (D+)
unnamed: RL3.1, UL1.3 (D-)
unnamed: CL3.1, UL1.6 (UCAP)
unnamed: CL1.2, UL1.17 (XTAL1), YL1.3
unnamed: CL2.1, UL1.16 (XTAL2), YL1.1
unnamed: RL4.2, UL1.33 (~HWB/PE2)
unnamed: RR2.1, UR1.4 (D+)
unnamed: RR3.1, UR1.3 (D-)
unnamed: CR3.1, UR1.6 (UCAP)
unnamed: CR1.2, UR1.17 (XTAL1), YR1.3
unnamed: CR2.1, UR1.16 (XTAL2), YR1.1
unnamed: RR4.2, UR1.33 (~HWB/PE2)
unnamed: RL6.2, USBL1.A5 (CC1)
unnamed: RL7.2, USBL1.B5 (CC2)
unnamed: RR6.2, USBR1.A5 (CC1)
unnamed: RR7.2, USBR1.B5 (CC2)
RE1A: REL00_1.A, UL1.25 (PD4)
RE1B: REL00_1.B, UL1.22 (PD5)
RE2A: REL00_2.A, UL1.26 (PD6)
RE2B: REL00_2.B, UL1.27 (PD7)
RESETL: RESETL_SW1.A, RESETL_SW1.B, RL5.2, UL1.13 (~RESET)
RESETR: RESETR_SW1.A, RESETR_SW1.B, RR5.2, UR1.13 (~RESET)
RLED: RLED1.4 (DIN), UR1.1 (PE6)
VCCL: ESDDL1.1 (A1), FL1.1, USBL1.A4 (VBUS), USBL1.A9 (VBUS), USBL1.B4 (VBUS), USBL1.B9 (VBUS)
VCCR: ESDDR1.1 (A1), FR1.1, USBR1.A4 (VBUS), USBR1.A9 (VBUS), USBR1.B4 (VBUS), USBR1.B9 (VBUS)
dataL: JL3.5, UL1.18 (PD0)
dataR: JR3.5, UR1.18 (PD0)
lcol01: REL00_1.S2, REL00_2.S2, SWL00_1.1, SWL00_9.1, SWL00_17.1, SWL00_25.1, SWL00_33.1, UL1.29 (PB5)
lcol02: SWL00_2.1, SWL00_10.1, SWL00_18.1, SWL00_26.1, SWL00_34.1, UL1.30 (PB6)
lcol03: SWL00_3.1, SWL00_11.1, SWL00_19.1, SWL00_35.1, UL1.12 (PB7)
lcol04: SWL00_4.1, SWL00_12.1, SWL00_20.1, SWL00_28.1, SWL00_36.1, UL1.31 (PC6)
lcol05: SWL00_5.1, SWL00_13.1, SWL00_21.1, SWL00_29.1, UL1.32 (PC7)
lcol06: SWL00_6.1, SWL00_14.1, SWL00_22.1, SWL00_30.1, SWL00_38.1, UL1.19 (PD1)
lcol07: SWL00_7.1, SWL00_15.1, SWL00_23.1, SWL00_31.1, UL1.20 (PD2)
lcol08: SWL00_8.1, SWL00_32.1, SWL00_40.1, UL1.21 (PD3)
lrow01: DL00_1.1 (K), DL00_2.1 (K), DL00_3.1 (K), DL00_4.1 (K), DL00_5.1 (K), DL00_6.1 (K), DL00_7.1 (K), DL00_8.1 (K), UL1.8 (PB0)
lrow02: DL00_9.1 (K), DL00_10.1 (K), DL00_11.1 (K), DL00_12.1 (K), DL00_13.1 (K), DL00_14.1 (K), DL00_15.1 (K), UL1.9 (PB1)
lrow03: DL00_17.1 (K), DL00_19.1 (K), DL00_21.1 (K), DL00_23.1 (K), DL00_25.1 (K), DL00_27.1 (K), DL00_29.1 (K), UL1.10 (PB2)
lrow04: DL00_18.1 (K), DL00_20.1 (K), DL00_24.1 (K), DL00_26.1 (K), DL00_28.1 (K), DL00_30.1 (K), DL00_32.1 (K), UL1.11 (PB3)
lrow05: DL00_33.1 (K), DL00_34.1 (K), DL00_35.1 (K), DL00_36.1 (K), DL00_38.1 (K), DL00_40.1 (K), UL1.28 (PB4)
rcol01: SWR00_1.1, SWR00_9.1, SWR00_17.1, SWR00_25.1, UR1.29 (PB5)
rcol02: SWR00_2.1, SWR00_10.1, SWR00_18.1, SWR00_26.1, SWR00_34.1, UR1.30 (PB6)
rcol03: SWR00_3.1, SWR00_11.1, SWR00_19.1, SWR00_27.1, UR1.12 (PB7)
rcol04: SWR00_4.1, SWR00_12.1, SWR00_20.1, SWR00_28.1, SWR00_36.1, UR1.31 (PC6)
rcol05: SWR00_5.1, SWR00_13.1, SWR00_21.1, SWR00_29.1, UR1.32 (PC7)
rcol06: SWR00_6.1, SWR00_14.1, SWR00_22.1, SWR00_30.1, SWR00_38.1, UR1.19 (PD1)
rcol07: SWR00_7.1, SWR00_15.1, SWR00_31.1, SWR00_39.1, UR1.20 (PD2)
rcol08: SWR00_8.1, SWR00_16.1, SWR00_24.1, SWR00_32.1, SWR00_40.1, UR1.21 (PD3)
rrow01: DR00_1.1 (K), DR00_2.1 (K), DR00_3.1 (K), DR00_4.1 (K), DR00_5.1 (K), DR00_6.1 (K), DR00_7.1 (K), DR00_8.1 (K), UR1.8 (PB0)
rrow02: DR00_9.1 (K), DR00_10.1 (K), DR00_11.1 (K), DR00_12.1 (K), DR00_13.1 (K), DR00_14.1 (K), DR00_15.1 (K), DR00_16.1 (K), UR1.9 (PB1)
rrow03: DR00_17.1 (K), DR00_19.1 (K), DR00_21.1 (K), DR00_23.1 (K), DR00_25.1 (K), DR00_27.1 (K), DR00_31.1 (K), UR1.10 (PB2)
rrow04: DR00_18.1 (K), DR00_20.1 (K), DR00_22.1 (K), DR00_24.1 (K), DR00_26.1 (K), DR00_28.1 (K), DR00_30.1 (K), DR00_32.1 (K), UR1.11 (PB3)
rrow05: DR00_34.1 (K), DR00_36.1 (K), DR00_38.1 (K), DR00_39.1 (K), DR00_40.1 (K), UR1.28 (PB4)

Notes on the sheet:
Controller R
KEYMATRIX R
DB L
LEDMATRIX L
DB R
LEDMATRIX R
KEYMATRIX L
Controller L

Board: 2 copper layers, 274 parts (0 on the bottom side), 223 nets, no tracks yet.
