bbrfkr/accelerator-keyboard/firmware/qmk/accelerator/keymaps/via/keymap.c

/* Copyright 2022 bbrfkr
 *
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
 * You should have received a copy of the GNU General Public License
 * along with this program.  If not, see <http://www.gnu.org/licenses/>.
 */

#include QMK_KEYBOARD_H

enum layer_names {
    _QWERTY,
    _LOWER,
    _RAISE,
    _SETTINGS,
};

const uint16_t PROGMEM keymaps[][MATRIX_ROWS][MATRIX_COLS] = {

    [_QWERTY] = LAYOUT_ansi(
        KC_F5,  KC_GRV,  KC_1,    KC_2,    KC_3,    KC_4,    KC_5,    KC_6,    KC_6,    KC_7,    KC_8,    KC_9,    KC_0,    KC_MINS, KC_EQL,  KC_BSPC,
        KC_MS_BTN3, KC_TAB,  KC_Q,    KC_W,    KC_E,    KC_R,    KC_T,             KC_Y,    KC_U,    KC_I,    KC_O,    KC_P,    KC_LBRC, KC_RBRC, KC_BSLS,
        KC_PSCR, KC_CAPS, KC_A,    KC_S,    KC_D,    KC_F,    KC_G,             KC_H,    KC_J,    KC_K,    KC_L,    KC_SCLN, KC_QUOT,          KC_ENT,
        KC_HOME, KC_LSFT,          KC_Z,    KC_X,    KC_C,    KC_V,    KC_B,    KC_B,    KC_N,    KC_M,    KC_COMM, KC_DOT,  KC_SLSH, KC_RSFT, MO(1),
        KC_END,  KC_LCTL, KC_LGUI, KC_LALT,          MO(1),            MO(2),            KC_SPC,           MO(2),            KC_RALT, KC_RGUI, KC_RCTL
    ),

    [_LOWER] = LAYOUT_ansi(
        RGB_TOG, KC_ESC,  KC_F1,   KC_F2,   KC_F3,   KC_F4,   KC_F5,   KC_F6,   KC_F6,   KC_F7,   KC_F8,   KC_F9,   KC_F10,  KC_F11,  KC_F12,  KC_DEL,
        KC_TRNS, KC_TRNS, KC_TRNS, KC_TRNS, KC_TRNS, KC_TRNS, KC_TRNS,          KC_TRNS, KC_TRNS, KC_TRNS, KC_TRNS, KC_TRNS, KC_TRNS, KC_TRNS, KC_TRNS,
        KC_TRNS, KC_TRNS, KC_TRNS, KC_MS_BTN2, KC_MS_BTN3, KC_MS_BTN1, KC_TRNS,          KC_LEFT, KC_DOWN, KC_UP,   KC_RGHT, KC_TRNS, KC_TRNS,          KC_TRNS,
        KC_TRNS, KC_TRNS,          KC_TRNS, KC_TRNS, KC_TRNS, KC_TRNS, KC_TRNS, KC_TRNS, KC_TRNS, KC_TRNS, KC_TRNS, KC_TRNS, KC_TRNS, KC_TRNS, KC_TRNS,
        KC_TRNS, KC_TRNS, KC_TRNS, KC_TRNS,          KC_TRNS,          MO(3),            KC_TRNS,          MO(3),            KC_TRNS, KC_TRNS, KC_TRNS
    ),

    [_RAISE] = LAYOUT_ansi(
        KC_MUTE, KC_ESC,  KC_F1,   KC_F2,   KC_F3,   KC_F4,   KC_F5,   KC_F6,   KC_F6,   KC_F7,   KC_F8,   KC_F9,   KC_F10,  KC_F11,  KC_F12,  KC_DEL,
        KC_TRNS, KC_TRNS, KC_TRNS, KC_TRNS, KC_TRNS, KC_TRNS, KC_TRNS,          KC_TRNS, KC_TRNS, KC_TRNS, KC_TRNS, KC_TRNS, KC_TRNS, KC_TRNS, KC_TRNS,
        KC_TRNS, KC_TRNS, KC_TRNS, KC_TRNS, KC_TRNS, KC_TRNS, KC_TRNS,          KC_TRNS, KC_TRNS, KC_TRNS, KC_TRNS, KC_TRNS, KC_TRNS,          KC_TRNS,
        KC_TRNS, KC_TRNS,          KC_TRNS, KC_TRNS, KC_TRNS, KC_TRNS, KC_TRNS, KC_TRNS, KC_TRNS, KC_TRNS, KC_TRNS, KC_TRNS, KC_TRNS, KC_TRNS, MO(3),
        KC_TRNS, KC_TRNS, KC_TRNS, KC_TRNS,          MO(3),            KC_TRNS,          KC_TRNS,          KC_NO,            KC_TRNS, KC_TRNS, KC_TRNS
    ),

    [_SETTINGS] = LAYOUT_ansi(
        QK_BOOT, KC_NO,   KC_NO,   KC_NO,   KC_NO,    KC_NO,   KC_NO,   RGB_TOG,  RGB_TOG,  KC_NO,   KC_NO,   KC_NO,   KC_NO,   KC_NO,   KC_NO,   QK_BOOT,
        KC_NO,   KC_NO,   KC_NO,   KC_NO,   KC_NO,    KC_NO,   RGB_HUI,           RGB_HUI,  KC_NO,   KC_NO,   KC_NO,   KC_NO,   KC_NO,   KC_NO,   KC_NO,
        KC_NO,   KC_NO,   KC_NO,   KC_NO,   KC_NO,    KC_NO,   RGB_HUD,           RGB_HUD,  KC_NO,   KC_NO,   KC_NO,   KC_NO,   KC_NO,            KC_NO,
        KC_NO,   KC_NO,            KC_NO,   KC_NO,    KC_NO,   KC_NO,   RGB_MOD,  RGB_MOD,  KC_NO,   KC_NO,   KC_NO,   KC_NO,   KC_NO,   KC_NO,   KC_NO,
        KC_NO,   KC_NO,   KC_NO,   KC_NO,             KC_NO,            KC_NO,             - KC_NO,            KC_NO,            KC_NO,   KC_NO,   KC_NO
    ),
};

#if defined(ENCODER_MAP_ENABLE)
const uint16_t PROGMEM encoder_map[][NUM_ENCODERS][NUM_DIRECTIONS] = {
    [_QWERTY] = { ENCODER_CCW_CW(KC_PGUP, KC_PGDN), ENCODER_CCW_CW(KC_WH_U, KC_WH_D), ENCODER_CCW_CW(KC_UP, KC_DOWN), ENCODER_CCW_CW(KC_LEFT, KC_RGHT) },
    [_LOWER] = { ENCODER_CCW_CW(RGB_MOD, RGB_RMOD), ENCODER_CCW_CW(KC_WH_U, KC_WH_D), ENCODER_CCW_CW(KC_UP, KC_DOWN), ENCODER_CCW_CW(KC_LEFT, KC_RGHT) },
    [_RAISE] = { ENCODER_CCW_CW(KC_VOLU, KC_VOLD), ENCODER_CCW_CW(KC_WH_U, KC_WH_D), ENCODER_CCW_CW(KC_UP, KC_DOWN), ENCODER_CCW_CW(KC_LEFT, KC_RGHT) },
    [_SETTINGS] = { ENCODER_CCW_CW(RGB_HUI, RGB_HUD), ENCODER_CCW_CW(KC_WH_U, KC_WH_D), ENCODER_CCW_CW(KC_UP, KC_DOWN), ENCODER_CCW_CW(KC_LEFT, KC_RGHT) },
};
#endif
